jbanks2/Sim-Seat-redux/center_lengths.PNG

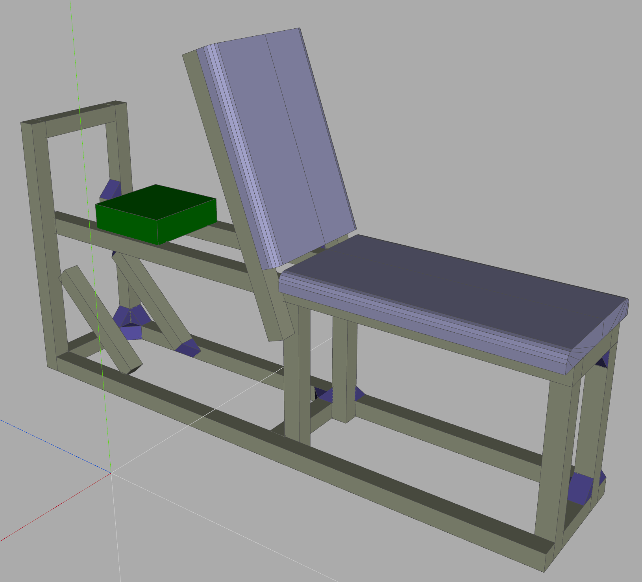
center_lengths.PNG
