jbanks2/Sim-Seat-redux/Driver and Center on pallet.PNG

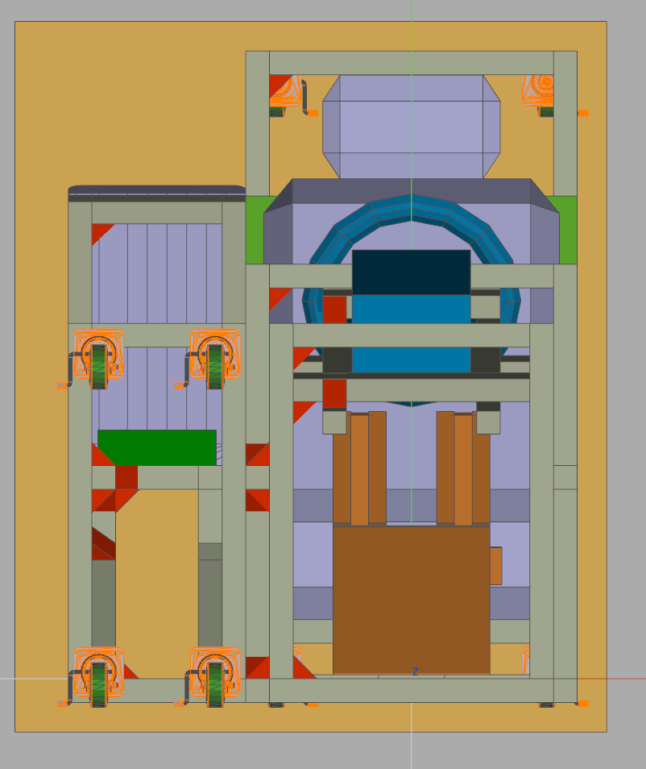
Driver and Center on pallet.PNG
