jbanks2/Sim-Seat-redux/Pallet sizesds.jpg

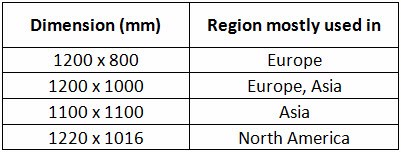
Pallet sizesds.jpg
