jbanks2/Sim-Seat-redux/Seat_lengths.PNG

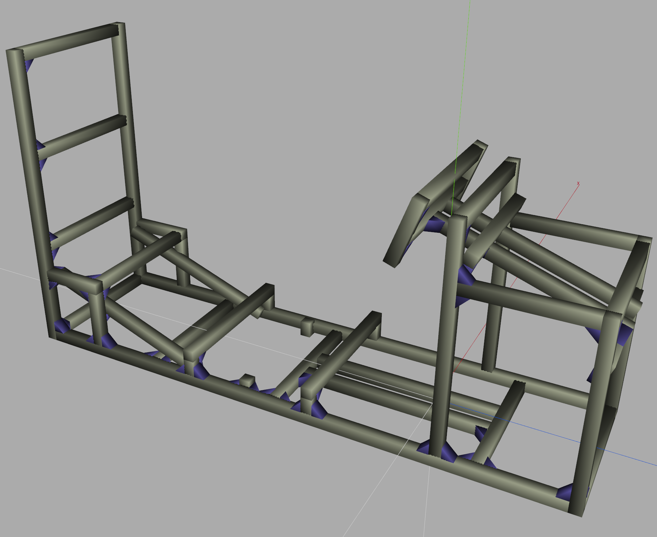
Seat_lengths.PNG
