jbanks2/Sim-Seat-redux/SIM-Seat-Redux-Floor-Plates.dxf

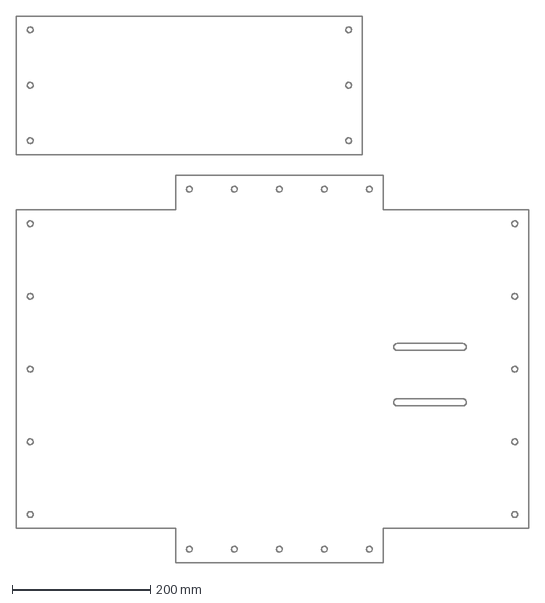
[picture p12: CAD file, 2016-04-21]
SIM-Seat-Redux-Floor-Plates.dxf
740.0 x 790.0 mm
