jbanks2/Sim-Seat-redux/(commit log)

2016-04-21 First draft of CAD and Manual
    [SIM-Seat-Redux-Floor-Plates.dxf]
2016-04-21 Finish Seat design rev 1
    [BOM.xlsx]
2016-07-25 Arduino/CAN shield seat activator
